macsleep/datalogger/src/RESTful.cpp

/*
  Copyright 2025 Jan Schlieper

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
  The author disclaims all warranties with regard to this
  software, including all implied warranties of merchantability
  and fitness.  In no event shall the author be liable for any
  special, indirect or consequential damages or any damages
  whatsoever resulting from loss of use, data or profits, whether
  in an action of contract, negligence or other tortious action,
  arising out of or in connection with the use or performance of
  this software.
 */

#include "RESTful.h"

RESTful::RESTful() {
}

void RESTful::begin(AsyncWebServer *httpd) {
    // rtc
    restRtc.begin(httpd);

    // timer, sheduler
    restTimer.begin(httpd);

    // logs
    restLogs.begin(httpd);

    // log file
    restLogFile.begin(httpd);

    // ota firmware
    httpd->on("^\\/api\\/firmware$", HTTP_GET, std::bind(&RESTful::firmwareVersion, this, std::placeholders::_1));
    httpd->on("^\\/api\\/firmware$", HTTP_POST,
              std::bind(&RESTful::firmwareUpload, this, std::placeholders::_1),
              std::bind(&RESTful::firmwareUploadChunks, this, std::placeholders::_1, std::placeholders::_2,
                        std::placeholders::_3, std::placeholders::_4, std::placeholders::_5, std::placeholders::_6));

    // system settings
    httpd->on("^\\/api\\/system$", std::bind(&RESTful::systemConfig, this, std::placeholders::_1));

    // modbus registers
    httpd->on("^\\/api\\/modbus$", HTTP_GET, std::bind(&RESTful::modbus, this, std::placeholders::_1));
    httpd->on("^\\/api\\/modbus\\/([0-9]+)$", std::bind(&RESTful::modbusValue, this, std::placeholders::_1));
    httpd->on("^\\/api\\/modbus\\/([0-9]+)\\/config$", std::bind(&RESTful::modbusConfig, this, std::placeholders::_1));

    // serial configuration
    httpd->on("^\\/api\\/serial1$", std::bind(&RESTful::serial1Config, this, std::placeholders::_1));
}

void RESTful::firmwareVersion(AsyncWebServerRequest *request) {
    String version = "???";

#ifdef GIT_HASH
    version = GIT_HASH;
#endif
    request->send(200, "text/plain", version);
}

void RESTful::firmwareUpload(AsyncWebServerRequest *request) {
    request->send(200);
}

void RESTful::firmwareUploadChunks(AsyncWebServerRequest *request, String filename, size_t index, uint8_t *data, size_t len, bool final) {
    if(!request->authenticate(settings.getHttpUser().c_str(), settings.getHttpPassword().c_str()))
        return request->requestAuthentication();

    if(!index) {
        request->_tempFile = SD.open("/firmware.bin", "w");
    }

    if(len) {
        request->_tempFile.write(data, len);
    }

    if(final) {
        request->_tempFile.close();
    }
}

void RESTful::systemConfig(AsyncWebServerRequest *request) {
    int i;
    String value = "";

    if(!request->authenticate(settings.getHttpUser().c_str(), settings.getHttpPassword().c_str()))
        return request->requestAuthentication();

    switch (request->method()) {
     case HTTP_GET:
         value = value + "wifiSSID=" + settings.getWifiSSID() + "&";
         value = value + "wifiPassword=" + settings.getWifiPassword() + "&";
         value = value + "httpUser=" + settings.getHttpUser() + "&";
         value = value + "httpPassword=" + settings.getHttpPassword();

         request->send(200, "application/x-www-form-urlencoded", value);
         break;

     case HTTP_PUT:
         for(i = 0; i < request->params(); i++) {
             if(request->getParam(i)->name().equals("wifiSSID")) {
                 settings.setWifiSSID(request->getParam(i)->value());
             }
             if(request->getParam(i)->name().equals("wifiPassword")) {
                 settings.setWifiPassword(request->getParam(i)->value());
             }
             if(request->getParam(i)->name().equals("httpUser")) {
                 settings.setHttpUser(request->getParam(i)->value());
             }
             if(request->getParam(i)->name().equals("httpPassword")) {
                 settings.setHttpPassword(request->getParam(i)->value());
             }
         }

         request->send(200);
         break;

     case HTTP_DELETE:
         settings.reset();

         request->send(200);
         break;

     default:
         request->send(400);
         break;
    }
}

void RESTful::modbus(AsyncWebServerRequest *request) {
    int i;
    ModbusConfig config;
    AsyncResponseStream *response;

    response = request->beginResponseStream("text/html");

    i = 0;
    while(settings.getModbusConfig(i, &config)) {
        response->println(String(i));
        i++;
    }

    request->send(response);
}

void RESTful::modbusValue(AsyncWebServerRequest *request) {
    int n, status;
    ModbusConfig config;
    String value = "";

    n = request->pathArg(0).toInt();

    switch (request->method()) {
     case HTTP_GET:
         status = 400;
         if(settings.getModbusConfig(n, &config)) {
             value = energyMeter.getModbus(config.deviceAddress, config.functionCode, config.registerAddress, config.valueType);
             status = 200;
         }
         request->send(status, "text/plain", value);
         break;

     default:
         request->send(400);
         break;
    }
}

void RESTful::modbusConfig(AsyncWebServerRequest *request) {
    int n, i, status;
    ModbusConfig config;
    String value = "";

    n = request->pathArg(0).toInt();

    switch (request->method()) {
     case HTTP_GET:
         status = 400;
         if(settings.getModbusConfig(n, &config)) {
             value = value + "deviceAddress=" + String(config.deviceAddress) + "&";
             value = value + "functionCode=" + String(config.functionCode) + "&";
             value = value + "registerAddress=" + String(config.registerAddress) + "&";
             value = value + "valueType=" + utils.typeToString(config.valueType);
             status = 200;
         }
         request->send(status, "application/x-www-form-urlencoded", value);
         break;

     case HTTP_PUT:
         if(!request->authenticate(settings.getHttpUser().c_str(), settings.getHttpPassword().c_str()))
             return request->requestAuthentication();

         status = 400;
         if(settings.getModbusConfig(n, &config)) {
             for(i = 0; i < request->params(); i++) {
                 if(request->getParam(i)->name().equals("deviceAddress")) {
                     config.deviceAddress = request->getParam(i)->value().toInt();
                 }
                 if(request->getParam(i)->name().equals("functionCode")) {
                     config.functionCode = request->getParam(i)->value().toInt();
                 }
                 if(request->getParam(i)->name().equals("registerAddress")) {
                     config.registerAddress = request->getParam(i)->value().toInt();
                 }
                 if(request->getParam(i)->name().equals("valueType")) {
                     config.valueType = utils.stringToType(request->getParam(i)->value());
                 }
             }
             if(request->params()) {
                 settings.setModbusConfig(n, &config);
                 status = 200;
             }
         }
         request->send(status);
         break;

     default:
         request->send(400);
         break;
    }
}


void RESTful::serial1Config(AsyncWebServerRequest *request) {
    int i;
    String value = "";

    switch (request->method()) {
     case HTTP_GET:
         value = "baud=" + String(settings.getSerial1Baud()) + "&";
         value = value + "config=" + utils.configToString((SerialConfig) settings.getSerial1Config());
         request->send(200, "application/x-www-form-urlencoded", value);
         break;

     case HTTP_PUT:
         if(!request->authenticate(settings.getHttpUser().c_str(), settings.getHttpPassword().c_str()))
             return request->requestAuthentication();

         for(i = 0; i < request->params(); i++) {
             if(request->getParam(i)->name().equals("baud")) {
                 settings.setSerial1Baud(request->getParam(i)->value().toInt());
             }
             if(request->getParam(i)->name().equals("config")) {
                 settings.setSerial1Config(utils.stringToConfig(request->getParam(i)->value()));
             }
         }
         request->send(200);
         break;

     default:
         request->send(400);
         break;
    }
}
