macsleep/datalogger/src/Timer_PFC8563.cpp

/*
  Copyright 2025 Jan Schlieper

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
  The author disclaims all warranties with regard to this
  software, including all implied warranties of merchantability
  and fitness.  In no event shall the author be liable for any
  special, indirect or consequential damages or any damages
  whatsoever resulting from loss of use, data or profits, whether
  in an action of contract, negligence or other tortious action,
  arising out of or in connection with the use or performance of
  this software.
 */

#include "Timer_PFC8563.h"

Timer_PFC8563::Timer_PFC8563() {
}

void Timer_PFC8563::enable(uint8_t value) {
    uint8_t data;

    // timer control
    Wire.beginTransmission(PCF8563_ADDRESS);
    Wire.write(PCF8563_TIMER_CONTROL);
    Wire.endTransmission();

    Wire.requestFrom(PCF8563_ADDRESS, 1);
    data = Wire.read();
    bitSet(data, 0);            // TD 1/60 Hz
    bitSet(data, 1);            // TD 1/60 Hz
    bitSet(data, 7);            // TE

    Wire.beginTransmission(PCF8563_ADDRESS);
    Wire.write(PCF8563_TIMER_CONTROL);
    Wire.write(data);
    Wire.endTransmission();

    // timer value
    Wire.beginTransmission(PCF8563_ADDRESS);
    Wire.write(PCF8563_TIMER);
    Wire.write(value);          // timer value
    Wire.endTransmission();

    // control status 2
    Wire.beginTransmission(PCF8563_ADDRESS);
    Wire.write(PCF8563_CONTROL_STATUS_2);
    Wire.endTransmission();

    Wire.requestFrom(PCF8563_ADDRESS, 1);
    data = Wire.read();
    bitSet(data, 0);            // TIE
    bitSet(data, 4);            // TI_TP

    Wire.beginTransmission(PCF8563_ADDRESS);
    Wire.write(PCF8563_CONTROL_STATUS_2);
    Wire.write(data);
    Wire.endTransmission();
}

bool Timer_PFC8563::isEnabled() {
    uint8_t data;
    bool flag;

    // timer control
    Wire.beginTransmission(PCF8563_ADDRESS);
    Wire.write(PCF8563_TIMER_CONTROL);
    Wire.endTransmission();

    Wire.requestFrom(PCF8563_ADDRESS, 1);
    data = Wire.read();
    flag = bitRead(data, 7);    // TE

    return (flag);
}

void Timer_PFC8563::disable(void) {
    uint8_t data;

    // control status 2
    Wire.beginTransmission(PCF8563_ADDRESS);
    Wire.write(PCF8563_CONTROL_STATUS_2);
    Wire.endTransmission();

    Wire.requestFrom(PCF8563_ADDRESS, 1);
    data = Wire.read();
    bitClear(data, 2);          // TF

    Wire.beginTransmission(PCF8563_ADDRESS);
    Wire.write(PCF8563_CONTROL_STATUS_2);
    Wire.write(data);
    Wire.endTransmission();

    // timer control
    Wire.beginTransmission(PCF8563_ADDRESS);
    Wire.write(PCF8563_TIMER_CONTROL);
    Wire.endTransmission();

    Wire.requestFrom(PCF8563_ADDRESS, 1);
    data = Wire.read();
    bitClear(data, 7);          // TE

    Wire.beginTransmission(PCF8563_ADDRESS);
    Wire.write(PCF8563_TIMER_CONTROL);
    Wire.write(data);
    Wire.endTransmission();
}

void Timer_PFC8563::clkoutEnable(void) {
    uint8_t data;

    // clkout control
    Wire.beginTransmission(PCF8563_ADDRESS);
    Wire.write(PCF8563_CLKOUT_CONTROL);
    Wire.endTransmission();

    Wire.requestFrom(PCF8563_ADDRESS, 1);
    data = Wire.read();
    bitClear(data, 0);          // FD 32.768 kHz
    bitClear(data, 1);          // FD 32.768 kHz
    bitSet(data, 7);            // FE CLKOUT output is activated

    Wire.beginTransmission(PCF8563_ADDRESS);
    Wire.write(PCF8563_CLKOUT_CONTROL);
    Wire.write(data);
    Wire.endTransmission();
}

void Timer_PFC8563::clkoutDisable(void) {
    uint8_t data;

    // clkout control
    Wire.beginTransmission(PCF8563_ADDRESS);
    Wire.write(PCF8563_CLKOUT_CONTROL);
    Wire.endTransmission();

    Wire.requestFrom(PCF8563_ADDRESS, 1);
    data = Wire.read();
    bitClear(data, 7);          // FE CLKOUT output is diabled

    Wire.beginTransmission(PCF8563_ADDRESS);
    Wire.write(PCF8563_CLKOUT_CONTROL);
    Wire.write(data);
    Wire.endTransmission();
}
