macsleep/datalogger/src/Settings.cpp

/*
  Copyright 2025 Jan Schlieper

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
  The author disclaims all warranties with regard to this
  software, including all implied warranties of merchantability
  and fitness.  In no event shall the author be liable for any
  special, indirect or consequential damages or any damages
  whatsoever resulting from loss of use, data or profits, whether
  in an action of contract, negligence or other tortious action,
  arising out of or in connection with the use or performance of
  this software.
 */

#include "Settings.h"

Settings::Settings() {
}

void Settings::reset(void) {
    int i;
    ModbusConfig config;

    nvs_flash_erase();
    nvs_flash_init();

    setWifiSSID(getWifiSSID());
    setWifiPassword(getWifiPassword());
    setHttpUser(getHttpUser());
    setHttpPassword(getHttpPassword());
    setTimer(getTimer());
    setSerial1Baud(getSerial1Baud());
    setSerial1Config(getSerial1Config());

    for(i = 0; i < MODBUS_SLOTS; i++) {
        getModbusConfig(i, &config);
        setModbusConfig(i, &config);
    }
}

String Settings::getWifiSSID(void) {
    char buffer[128] = "";
    uint64_t mac = ESP.getEfuseMac();
    sprintf(buffer, "%s_%02X%02X%02X", SYSTEMNAME, uint8_t((mac >> 24) & 0xff), uint8_t((mac >> 32) & 0xff), uint8_t((mac >> 40) & 0xff));
    buffer[0] = toupper(buffer[0]);
    String ssid = String(buffer);

    preferences.begin(SYSTEMNAME, RO_MODE);
    String value = preferences.getString("wifiSSID", ssid.c_str());
    preferences.end();
    return (value);
}

void Settings::setWifiSSID(String value) {
    if(preferences.begin(SYSTEMNAME, RW_MODE)) {
        preferences.putString("wifiSSID", value.c_str());
        preferences.end();
    }
}

String Settings::getWifiPassword(void) {
    preferences.begin(SYSTEMNAME, RO_MODE);
    String value = preferences.getString("wifiPassword", "12345678");
    preferences.end();
    return (value);
}

void Settings::setWifiPassword(String value) {
    if(preferences.begin(SYSTEMNAME, RW_MODE)) {
        preferences.putString("wifiPassword", value.c_str());
        preferences.end();
    }
}

String Settings::getHttpUser(void) {
    preferences.begin(SYSTEMNAME, RO_MODE);
    String value = preferences.getString("httpUser", "admin");
    preferences.end();
    return (value);
}

void Settings::setHttpUser(String value) {
    if(preferences.begin(SYSTEMNAME, RW_MODE)) {
        preferences.putString("httpUser", value.c_str());
        preferences.end();
    }
}

String Settings::getHttpPassword(void) {
    preferences.begin(SYSTEMNAME, RO_MODE);
    String value = preferences.getString("httpPassword", "admin");
    preferences.end();
    return (value);
}

void Settings::setHttpPassword(String value) {
    if(preferences.begin(SYSTEMNAME, RW_MODE)) {
        preferences.putString("httpPassword", value.c_str());
        preferences.end();
    }
}

uint8_t Settings::getTimer(void) {
    preferences.begin(SYSTEMNAME, RO_MODE);
    uint8_t value = preferences.getUChar("timer", 0);
    preferences.end();
    return (value);
}

void Settings::setTimer(uint8_t value) {
    if(preferences.begin(SYSTEMNAME, RW_MODE)) {
        preferences.putUChar("timer", value);
        preferences.end();
    }
}

bool Settings::getModbusConfig(uint8_t n, ModbusConfig *config) {
    char key[16];

    if(n >= MODBUS_SLOTS) return (false);

    preferences.begin(SYSTEMNAME, RO_MODE);
    snprintf(key, sizeof(key), "modbus_%d", n);
    if(preferences.isKey(key) && preferences.getBytesLength(key) == sizeof(ModbusConfig)) {
        preferences.getBytes(key, config, sizeof(ModbusConfig));
    } else bzero(config, sizeof(ModbusConfig));
    preferences.end();

    return (true);
}

bool Settings::setModbusConfig(uint8_t n, ModbusConfig *config) {
    char key[16];

    if(n >= MODBUS_SLOTS) return (false);

    if(preferences.begin(SYSTEMNAME, RW_MODE)) {
        snprintf(key, sizeof(key), "modbus_%d", n);
        preferences.putBytes(key, config, sizeof(ModbusConfig));
        preferences.end();
    }

    return (true);
}

unsigned long Settings::getSerial1Baud(void) {
    preferences.begin(SYSTEMNAME, RO_MODE);
    unsigned long value = preferences.getULong("serial1Baud", 9600);
    preferences.end();
    return (value);
}

void Settings::setSerial1Baud(unsigned long value) {
    if(preferences.begin(SYSTEMNAME, RW_MODE)) {
        preferences.putULong("serial1Baud", value);
        preferences.end();
    }
}

uint32_t Settings::getSerial1Config(void) {
    preferences.begin(SYSTEMNAME, RO_MODE);
    uint32_t value = preferences.getUInt("serial1Config", SerialConfig::SERIAL_8N1);
    preferences.end();
    return (value);
}

void Settings::setSerial1Config(uint32_t value) {
    if(preferences.begin(SYSTEMNAME, RW_MODE)) {
        preferences.putULong("serial1Config", value);
        preferences.end();
    }
}
