macsleep/datalogger/(commit log)

2025-05-22 pretty print
2025-05-23 capacitor value
2025-05-27 added timer to REST
2025-05-27 added disable timer
2025-05-27 timer docu
2025-06-07 rs485 resistors
2025-06-08 spi typo
2025-07-09 printf format
2025-07-12 rtc, timer api
2025-07-13 added year filter
2025-07-13 added sync.pl filter
2025-07-20 button wakeup
2025-07-27 new pcb
2025-08-10 trimmer capacitor closes #2
2025-08-22 timer json
2025-09-14 error in filter
2025-10-12 modbus slots json
2025-10-18 RTC and timer
2025-10-30 worked on error messages
    [Finder.cpp, Utils.cpp, Utils.h, datalogger.ino]
